anjennings/Tom80/V3/src/gal/U2101/README.md

# U2101
CPU GAL logic
See logic.pld for pin descriptions
