anjennings/Tom80/Schematics/Tom80 V2/V2.pdf

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
Title

Size | Number | Revision
C
Date: | 5/31/2021 | Sheet of
File: | Tom80V2.SchDoc | Drawn By:

A11 1
A12 2
A13 3
A14 4
A15 5
CLK 6
D4 7
D3 8
D5 9
D6 10
+5V 11
D2 12
D7 13
D0 14
D1 15
INT 16
NMI 17
HALT 18
MREQ 19
IORQ 20 | RD | 21 WR | 22 BUSAK | 23 WAIT | 24 BUSRQ | 25 RESET | 26 M1 | 27 RFSH | 28 GND | 29 A0 | 30 A1 | 31 A2 | 32 A3 | 33 A4 | 34 A5 | 35 A6 | 36 A7 | 37 A8 | 38 A9 | 39 A10 | 40

Z80

Zilog Z84C0008PEG

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
A11 | A10
A12
A13
A14
A15

Reset

WRITE
READ

MREQ
+5 | IORQ

CLK

GND

NC 1

Ground 7

RF-Out | 8
Vcc | 14

ZCLK

Abracon AACO-20.000MHZ-EK

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
Reset

+5

GND

C-RES

### 22 pf

M1

HALT

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
HALT

O2

OUT1

OUT2

POW
+5

1

2

3

P1

GND

## Master Reset Logic

## Z80 Clock

## Wall Wart

## Status LED Array

## Z80 CPU

D0 1
D1 2
D2 3
D3 4
D4 5
D5 6
D6 7
D7 8

ADS 25

A0 28
A1 27
A2 26

CS2 14

CTS 36

CS0 12
CS1 13
DCD | 38 DSR | 37

MR 35

RD 21

RI | 39
RCLK | 9

RD 22

SIN | 10
WR 18 | WR 19

XIN 16

BAUDOUT | 15
DTR | 33

DDIS 23

INTR | 30
OUT1 | 34
OUT2 | 31
RTS | 32

RXRDY 29

SOUT 11

TXRDY 24

XOUT 17

VDD 40 | VSS | 20

UART

PC16550DN

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
READ

WRITE

VDD 1

GP0 2
GP1 3
GP2 7
GP3 8

RST 4

URx 5
UTx 6

SDA 9
SCL 10
VUSB | | 11
D- | 12 D+ | 13
VSS | 14

USB-UART

Microchip MCP2221-I/P

+5

GND

Reset

D-D+

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
nReset

D+ 3

D- 2

GND 4

VBUS 1

5
6

PORT01

+5

XOUT 1 2

UCLK
Crystal

CX1

22pF

CX2

22pF

GND

XIN

XOUT

C-VU

22pF

OUT1
OUT2

DTR Acts as a latch to control the rom bank

ROM_LATCH

## 16550 Clock

RX

TX

GND

## UART-USB Bridge

## 16C550 UART

1
2
3
4
5
6
Vss 7 | 8

9

10

11

12

### 13 Vdd 14 NAND

Texas Instruments CD4011BM96 GND

1A 1
1B 2
1Y 3
2A 4
2B 5
2Y 6
GND 7
Vcc | 14
4A | 13
4B | 12
4Y | 11
3A | 10
3B | 9
3Y | 8

OR

SN74LS32N
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
G = nA 2

H = nB | 4
I =nC | 6
J = nD | 8
K = nE | 10
L = nF | 12
VDD | 14
VSS | 7

NOT

SYM-6032a9384922bff5-1

+5

GND

EN_RAM

E3 6

E2 5

E1 4

C

3

B

2

A

1 | Y0 | 15
| Y1 | 14
| Y2 | 13
| Y3 | 12
| Y4 | 11
| Y5 | 10
| Y6 | 9
| Y7 | 7
VCC | 16 GND 8

3-to-8 Decoder

MUX

A3

+5

GND

IORQ

/(nA15 * ROM_LATCH) = EN_ROM (Low At Reset)

EN_ROM

## NOT Gate

## Multiplexor

## NAND Gate

## OR Gate

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
EEPROM

Atmel AT28C256-15PU

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
MEMREAD

+5

+5

A0 | 12
A1 | 11
A2 | 10
A3 | 9
A4 | 8
A5 | 7
A6 | 6
A7 | 5
A8 | 27
A9 | 26
A10 | 23
A11 | 25
A12 | 4
A13 | 28
A14 | 3
A15 | 31
A16 | 2
A17 | 30
A18 | 1

DQ0 13
DQ1 14
DQ2 15
DQ3 17
DQ4 18
DQ5 19
DQ6 20
DQ7 21

OE 24
CE 22
WE 29

VCC 32 GND 16

SRAM

AS6C4008-55PCN

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
MEMREAD

MEMWRITE

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
SRAM enabled when ROM Disabled

Only Enabled when A15 Low AND Latch Set

EN_ROM

EN_RAM

## SRAM

## EEPROM

## Z80 PIO

GND

GND

C02

### 22 pf

C03
22pF

C04
22pF

C05
22pF

C06
22pF

C07
22pF

C08
22pF

C00
22pF

C01
22pF

+5

C09

### 22 pf

MEMREAD

READ

MREQ

RESET

nRESET

ROM_LATCH
nA15

EN_ROM

MREQ
WRITE
MEMWRITE

A15

nA15

D0 19
D1 20
D2 1

D7 2

D6 3

CE 4

C/D SEL 5

B/A SEL 6

PA7 | 7
PA6 | 8
PA5 | 9
PA4 | 10

GND 11

PA3 | 12 PA2 | 13 PA1 | 14 PA0 | 15
ASTB | 16
BSTB | 17
ARDY | 18
BRDY | 21

IEO 22

INT 23
IEI 24

CLK 25

+5V 26

PB0 | 27
PB1 | 28
PB2 | 29
PB3 | 30
PB4 | 31
PB5 | 32
PB6 | 33
PB7 | 34
RD 35 | IORQ 36 | M1 37
D5 38 | D4 39 | D3 40
Z80 PIO

PIO

Zilog Z84C2008PEG

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
PIO_EN
M1
IORQ
READ

+5

GND CLK

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
ARDY

BRDY

ASTB

BSTB

A0
A1

+5

PIO_SEL

PIO_INT

P0 | 1
P1 | 2
P2 | 3
P3 | 4
P4 | 5
P5 | 6
P6 | 7
P7 | 8

GND 9

BOEn 10
RESn 11

3.3V 12

P8 | 13 P9 | 14 P10 | 15 P11 | 16 P12 | 17 P13 | 18 P14 | 19 P15 | 20
P16 | 21 P17 | 22 P18 | 23 P19 | 24 P20 | 25 P21 | 26 P22 | 27 P23 | 28

GND 29

XI 30

XO 31

3.3V 32

P24 | 33 P25 | 34 P26 | 35 P27 | 36 P28 | 37 P29 | 38 P30 | 39 P31 | 40

PROP

Parallax P8X32A-D40

GND

+3.3

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
Case
Case

DB15-VGA

1-1734344-2
GND

VGA_BLU

VGA_GRN

VGA_RED

GND
VGA_HS
VGA_VS

1 2
PCLK
Crystal

+3.3

GND

A0 1

SDA 5

A2 3

A1 2 | WP | 7
VSS | 4
SCL | 6

VCC 8

S-ROM

24LC512-I/P

+3.3

SCL
SDA

GND

SCL

SDA

DAT2 1
CD/DAT3 2

CMD 3

VDD 4

CLK 5

VSS 6

DAT0 7
DAT1 8
S3 | 13
S4 | 14
| | S1 | 9
CD 11 | SW 10 | S2 | 12
| | S5 | 15

J03

MOLEX 503182-1852

GND

SD_D0

SD_CS

SD_DI
SD_CLK

SD_CD

+3.3

GND

PS2_DAT

PS2/CLK

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
VGA_BLU

VGA_GRN

VGA_RED

VGA_HS
VGA_VS

RB1

RG1

RR1

INT

(CTC_INT * PIO_INT) = INT (HIGH At Reset) nA15 and ROM_LATCH are HIGH at RESET

EN_ROM is LOW (active) at reset

ROM Disabled when addr > 0x7FFF or ROM_LATCH Low

Port A and all status lines are used for interfacing with Propeller

Used to interface with PS/2 Keyboard, VGA, and SD Card

SD_D0

SD_CS

SD_DI

SD_CLK

GND

PROP_RST

PROP_TX

PROP_RX

PS2_DAT
PS2/CLK

1
2
3
4

J02

61300411021

PROP_RST

PROP_RX

PROP_TX

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
# 6 GND GND

PS2

VCC | +5

GND

C101
.33uF

C100
100nF

C102
100nF

C103
10uF
Keystone 4816 | Keystone 4816 | Keystone 4816 | Keystone 4816

Footprint is 4816, use 2102-632-AL

CP-2260-ND

VGA_BLU | RB0
VGA_GRN | RG0
VGA_RED | RR0
IN 1 | 2
OUT | 3
GND

V02

LF33ABV

+3.3

SDA
SD_D0
SD_CS
SD_DI
SD_CLK

3 14

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
4116R-1-332

PA7

PA6

PA5

PA4

PA3

PA2

PA1

PA0 | P0 P1 P2 P3

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
SIP01

ARDY - Output, Active High - When High, data is available in the output register
ASTDB - Input, Active Low - When low, data from output register is gated onto the bus

BRDY - Output Active High - When high, Port A input is empty and ready to accept new data BSTDB - Input Active Low - When low, strobes data into Port A input register

+5

DCIN 1 | 2
VBAT | 3
GND

V01

7805

VCC

3 14

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
4116R-1-332

BSTB
BRDY
ASTB
ARDY
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
Reset | PROP_RST

CTC_SEL

PB1

PB0

PB2

D4 1
D5 2
D6 3
D7 4 | GND

5

RD 6

ZC/TO0 | 7
ZC/TO1 | 8
ZC/TO2 | 9

IORQ 10

IEO 11
INT 12

IEI 13

M1 14 | CLK 15

CE 16
RESET 17 CS0 18
CS1 19
CLK/TRG3 | 20
CLK/TRG2 | 21
CLK/TRG1 | 22
CLK/TRG0 | 23 +⁵V 24

D0 25
D1 26
D2 27
D3 28

CTC

Zilog Z84C3008PEG

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
CTC_EN

M1
IORQ
READ

CTC_INT

CTC_INT
PIO_INT
nINT

Reset

+5 GND

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
Power

NKK Switches CS12ANW03

VCC

C10

### 22 pf

1

2

VUSB

Molex 43045-0202

+5

JMPR

Sullins QPC02SXGN-RC

PS2_DAT

PS2/CLK

PIO_INT_O

PIO_INT_O
CTC_INT_O

M1
IORQ
INT_ACK

INT_ACK

INT_ACK is active low

IORQ

A4

INT

nINT

CTC_SEL
INT_ACK
nCTC_EN

nCTC_EN

CTC_EN

PIO_SEL

INT_ACK

nPIO_EN

nPIO_EN

PIO_EN

A4

PIO is bXXX00XAA (0-3)
CTC is bXXX01XAA (8-11)

UART is XXX1XAAA (16-23)

Pins 0-2 of Port B are used for Ram Bank Control

IO Enables are active (low) when Interrupt is acknowledged or when port is selected

M1

10K

C20

### 22 pf

+3.3

GND

This schematic has several KNOWN ISSUES.

# It is provided for reference ONLY

## PS2 Port

## SD Card
