anjennings/Tom80/Schematics/EEPROM Programmer/EEPROM Programmer.pdf

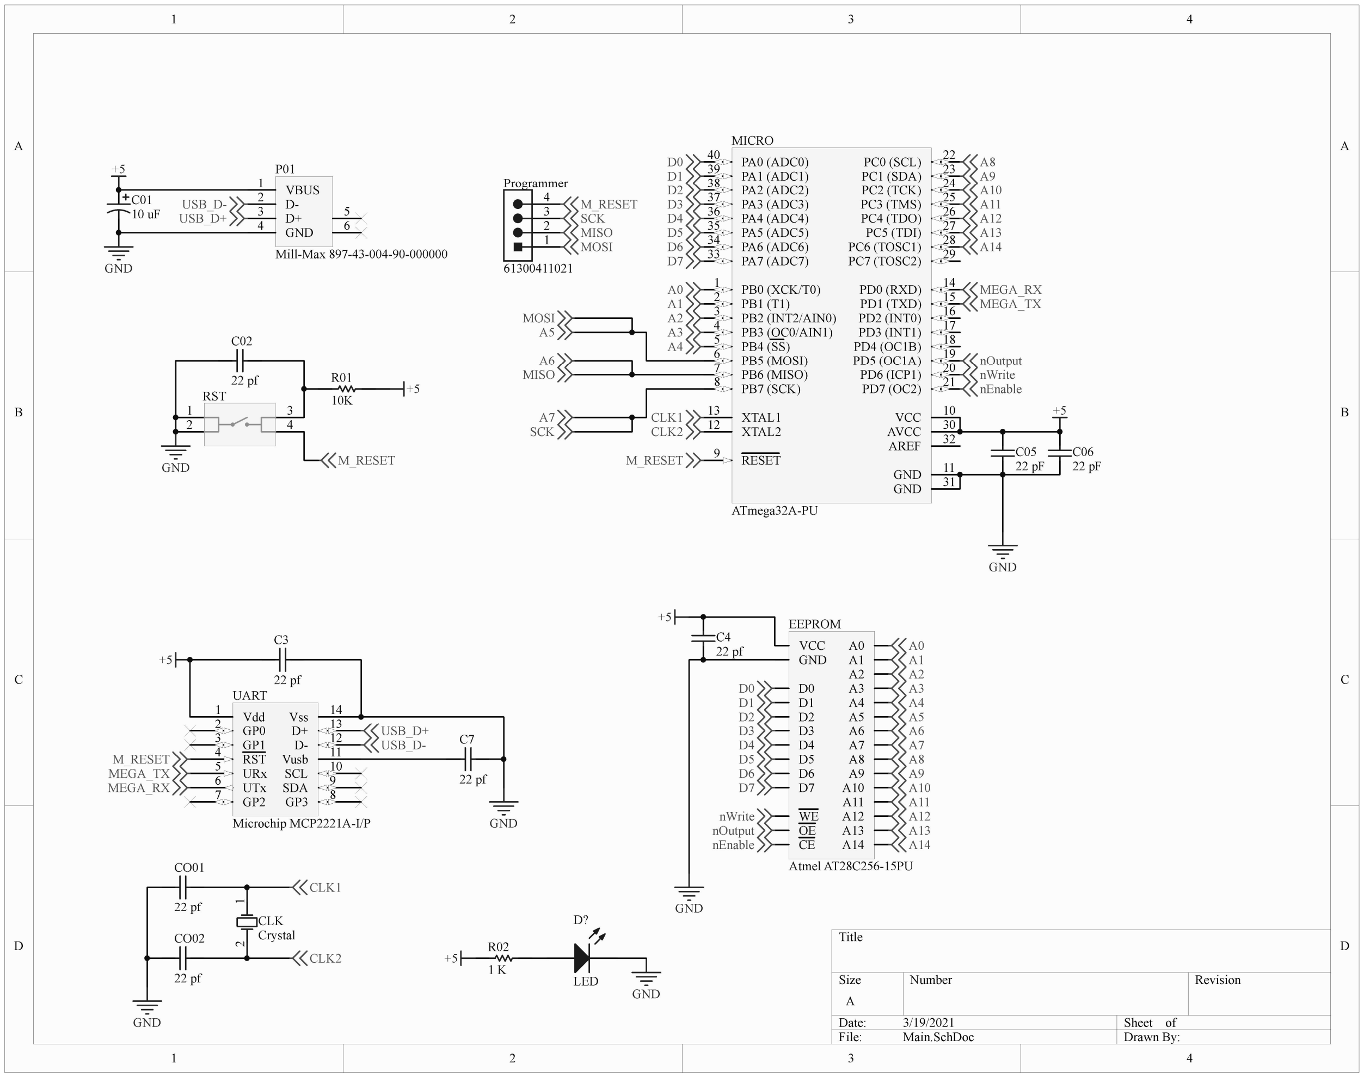
[picture p2: page 1]

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
Title

Size | Number | Revision
A
Date: | 3/19/2021 | Sheet of
File: | Main.SchDoc | Drawn By:

D+ 3

D- 2

GND 4

VBUS 1

5
6

P01

Mill-Max 897-43-004-90-000000

USB_D-USB_D+

Vdd 1
GP0 2
GP1 3
RST 4
URx 5
UTx 6
GP2 7 | GP3 | 8
| SDA | 9
SCL | 10 Vusb | 11 D- | 12 D+ | 13 Vss | 14

UART

Microchip MCP2221A-I/P

USB_D+
USB_D-M_RESET

GND

PB0 (XCK/T0) 1
PB1 (T1) 2
PB2 (INT2/AIN0) 3
PB3 (OC0/AIN1) 4
PB4 (SS) 5
PB5 (MOSI) 6
PB6 (MISO) 7
PB7 (SCK) 8

RESET 9

XTAL2 12 | XTAL1 13
PD0 (RXD) | 14
PD1 (TXD) | 15
PD2 (INT0) | 16
PD3 (INT1) | 17
PD4 (OC1B) | 18
PD5 (OC1A) | 19
PD6 (ICP1) | 20
PD7 (OC2) | 21
PC0 (SCL) | 22
PC1 (SDA) | 23
PC2 (TCK) | 24
PC3 (TMS) | 25
PC4 (TDO) | 26
PC5 (TDI) | 27
PC6 (TOSC1) | 28
PC7 (TOSC2) | 29 PA7 (ADC7) 33 | PA6 (ADC6) 34 | PA5 (ADC5) 35 | PA4 (ADC4) 36 | PA3 (ADC3) 37 | PA2 (ADC2) 38 | PA1 (ADC1) 39 | PA0 (ADC0) 40
VCC | 10
GND | 11
AVCC | 30
GND | 31
AREF | 32

MICRO

ATmega32A-PU

MEGA_RX
MEGA_TX

GND

M_RESET

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
EEPROM

Atmel AT28C256-15PU

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
nWrite

nEnable

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
CLK1
CLK2

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
MEGA_RX

MEGA_TX

1

2

3

4

Programmer

61300411021

MOSI

MISO

SCK

M_RESET

MOSI

SCK

MISO
nEnable

nWrite

+5

GND

nOutput

nOutput

+5

1 +5
2

3
4

RST

M_RESET

+5

GND

C01

### 10 uF

D?

LED

R02

### 1 K

+5

GND

R01
10K

C3

### 22 pf

C02

### 22 pf

C4

### 22 pf

C06

### 22 pF

C05

### 22 pF

C7

### 22 pf 1 2

CLK
Crystal

CO01

### 22 pf

CO02

### 22 pf

GND

CLK1

CLK2
