anjennings/Tom80/Old/README.md

# Old Files

Everything in this directory is old and no longer in development
Most of these files are related to prototypes or the original EEPROM programmer
