anjennings/Tom80/V2/src/README.md

# Assembly Source Code

Dump of all the assembly programs I've written for V2.  Some are just tests of peripherals while others are ongoing projects.  

* ASH - Memory monitor, mostly finished
* CPM - Port of CPM 2.2, unfinished and untested
* CPM_Bootloader - Bootloader routine to launch CPM
* Tinybasic - Version of Tinybasic ported by [Doug Gabbard](retroDepot.net), modified for Tom80
* FUZIX - Backup files for a port of FUZIX, requires a fork of EtchedPixels/FUZIX repo to compile, V2B only
* Shared - header files for ASH/CPM/Bootloader

Makefiles require you to specify the location of an assembler executable

Everything else is some test used to see if some aspect of the board is functioning.  I make no claims about the quality of these tests,  none of them are designed to be all encompassing.

## Assemblers

If a makefile is included its probably designed for
[Pasmo](http://pasmo.speccy.org/)

Otherwise you can use [ASM80](https://www.asm80.com/)
