anjennings/Tom80/V1/README.md

# Tom80 V1.X

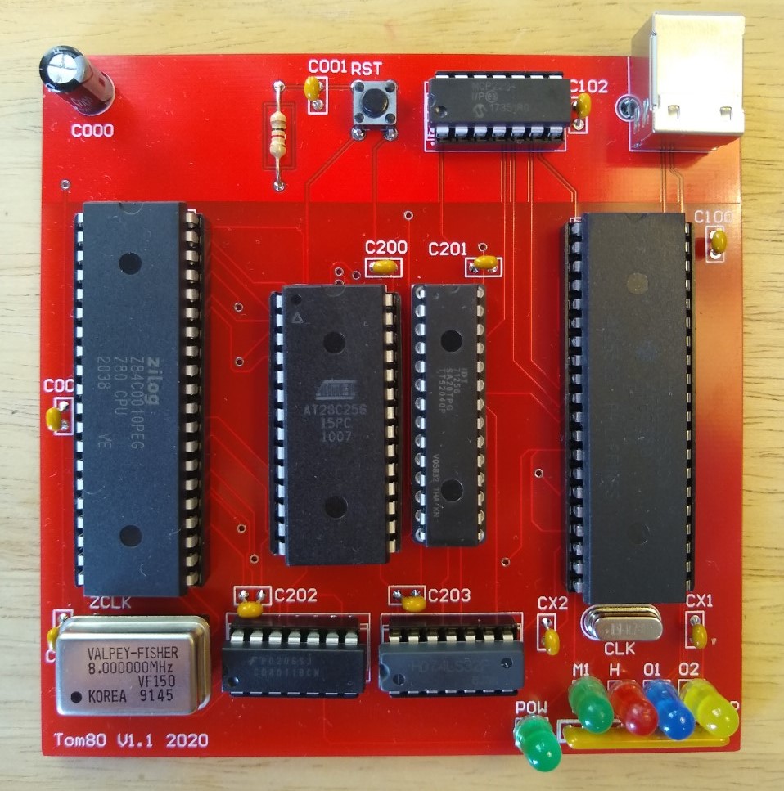
[picture p3: Photos/Tom80.jpg]


Two versions of V1 exist:

	* V1.0 - Never got it working, only version assembled was scrapped for parts
	* V1.1 - The one in all the pictures
	
See the video about it : https://youtu.be/3KAjZbjPqnA
	
This version has no persistant memory or way of keeping time so an OS wouldn't really be worth the effort

It can run BASIC and looks nice on the shelf
