anjennings/Tom80/Photos/EEPROM Programmer.jpg

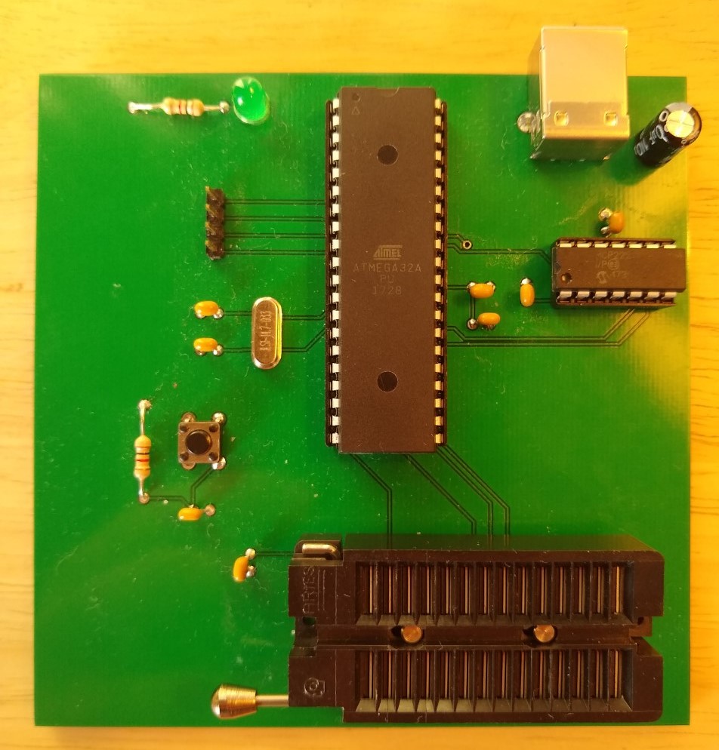
Photos/EEPROM Programmer.jpg
