anjennings/Tom80/Photos/Prototype 1.jpg

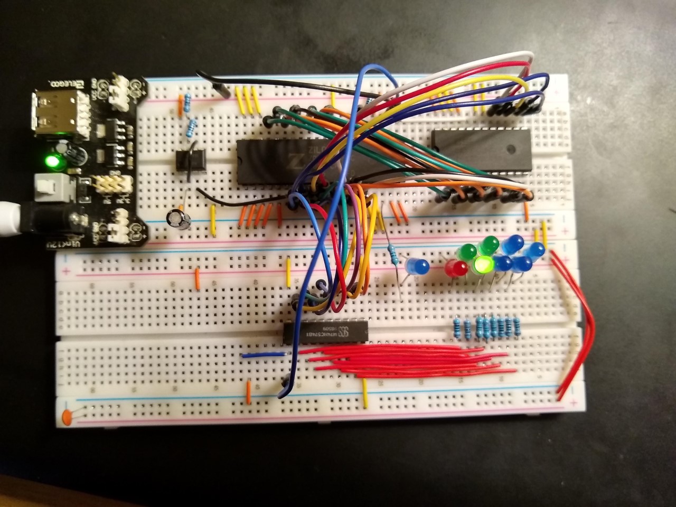
Photos/Prototype 1.jpg
