anjennings/Tom80/Photos/Prototype 2.jpg

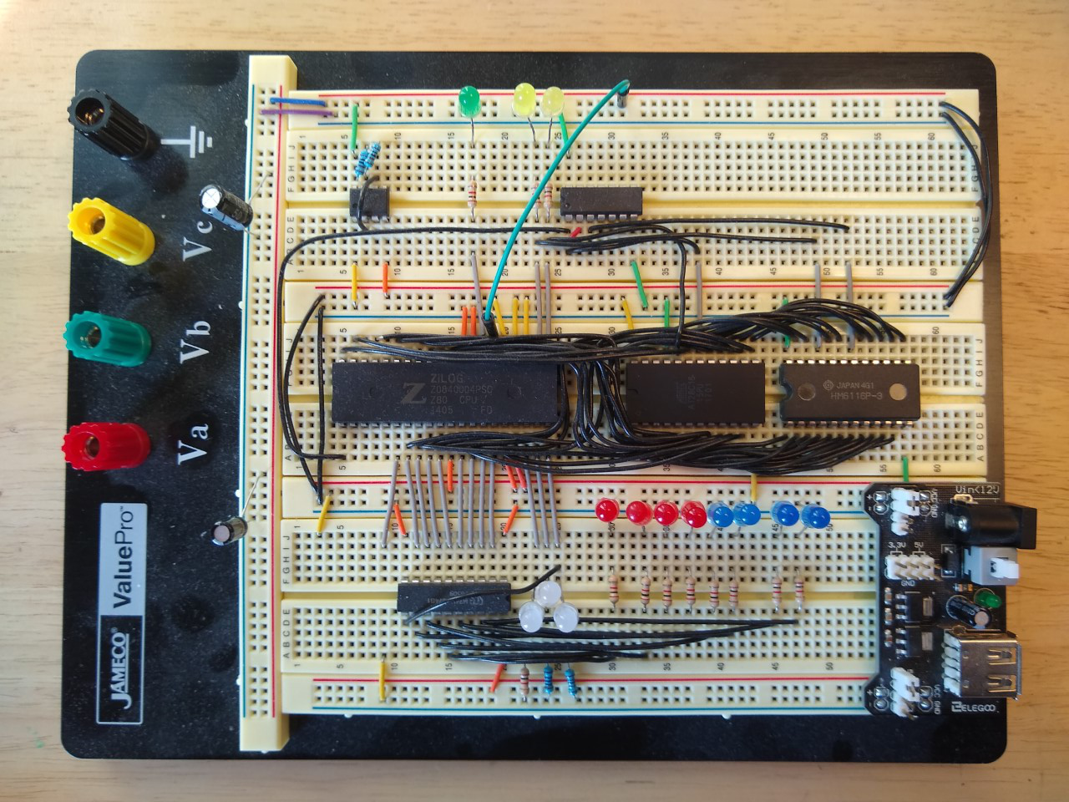
Photos/Prototype 2.jpg
