anjennings/Tom80/Photos/V2 Partial.jpg

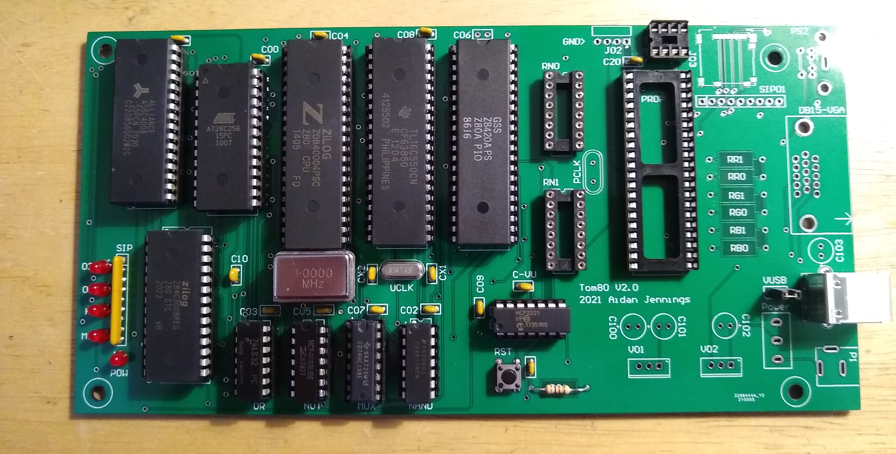
Photos/V2 Partial.jpg
