anjennings/Tom80/(threads)

Thread 1 (2021-03-19):

unconnected tag

mrobl320, 2021-03-19:
On the schematic for the eeprom programmer there is a VUSB tag that is not connected to anything so does it go to some pin of something or not?

anjennings, 2021-03-19:
VUSB should be connected to a capacitor if operating at 5V, per the datasheet, good catch.
This was added in a later version of the schematic that I have apparently failed to upload.
Sorry about any confusion this may have caused.

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

anjennings, 2021-03-19:
New version of schematic is now in master

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

Closed 2021-03-19.
