anjennings/Tom80/V3/kicad/z80vga.pdf

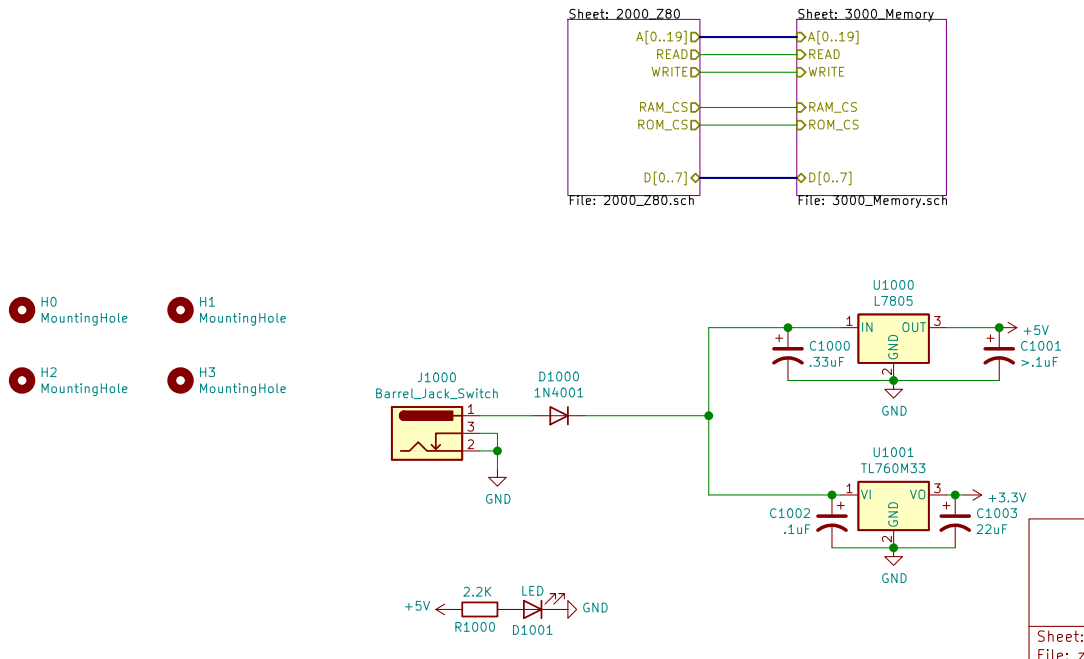
[picture p8: page 1]

Sheet: 2000_Z80 File: 2000_Z80.sch D[0..7] WRITE READ

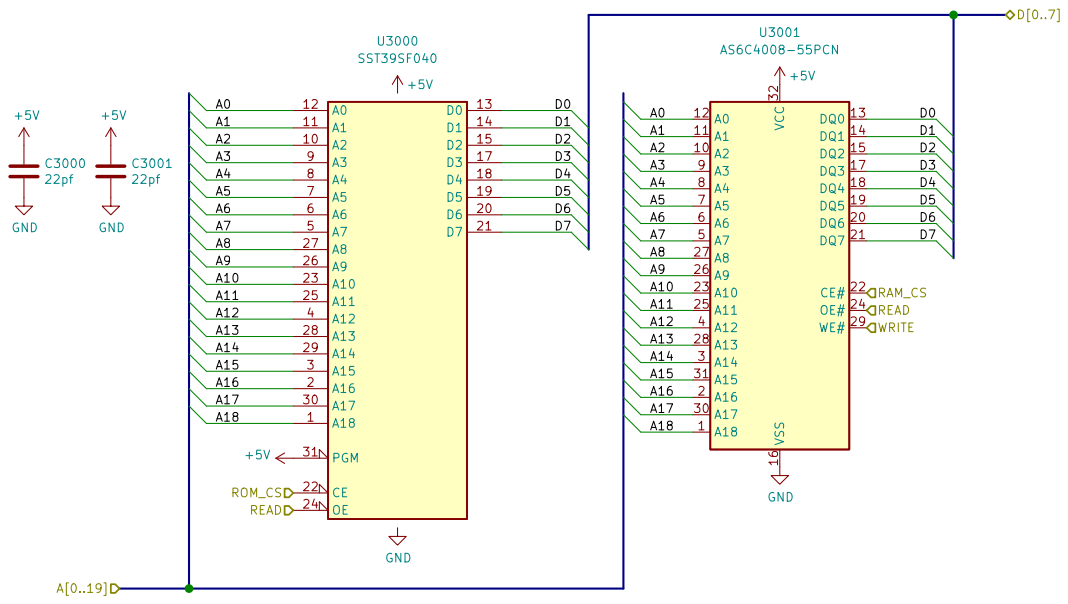
[picture p9: page 2]

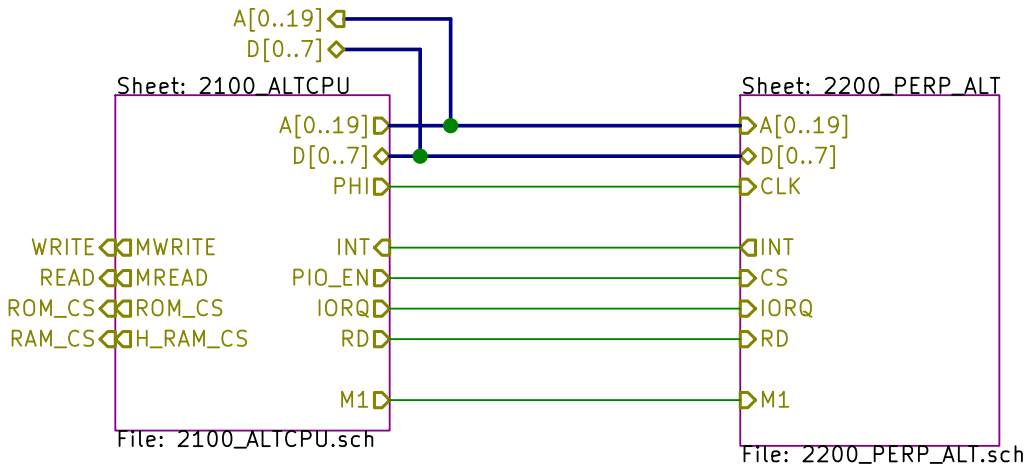
[picture p10: page 3]

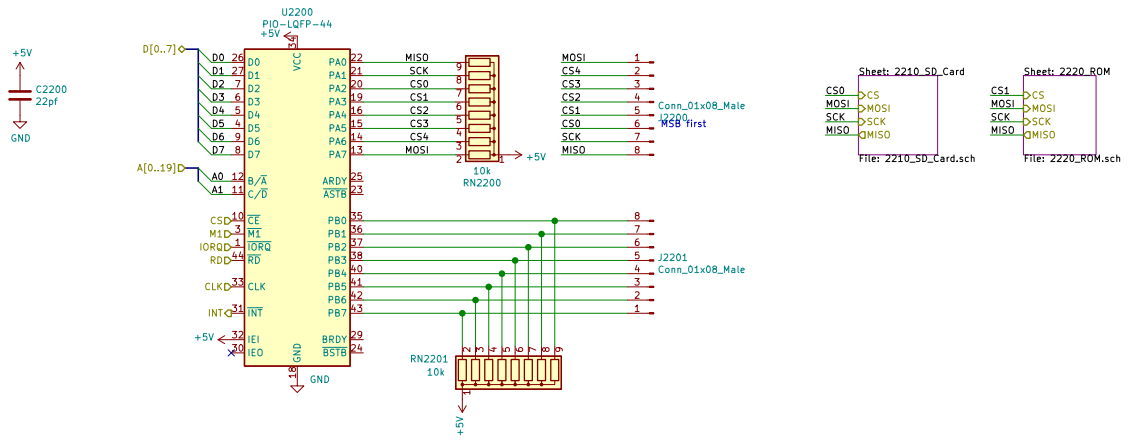
[picture p11: page 4]

Sheet: 2210_SD_Card File: 2210_SD_Card.sch CSMOSI SCK MISO

File: 2220_ROM.sch CSMOSI MISO

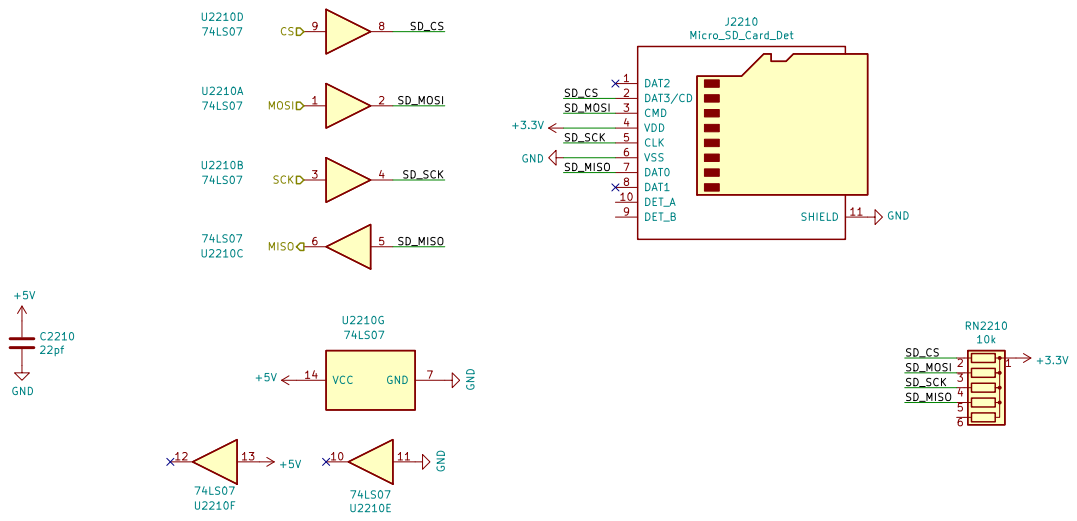
[picture p12: page 5]

J2210 Micro_SD_Card_Det +5V
+3.3V CS MOSI SCK MISO

SD_MOSI SD_CS
SD_MISO This page has been checked!

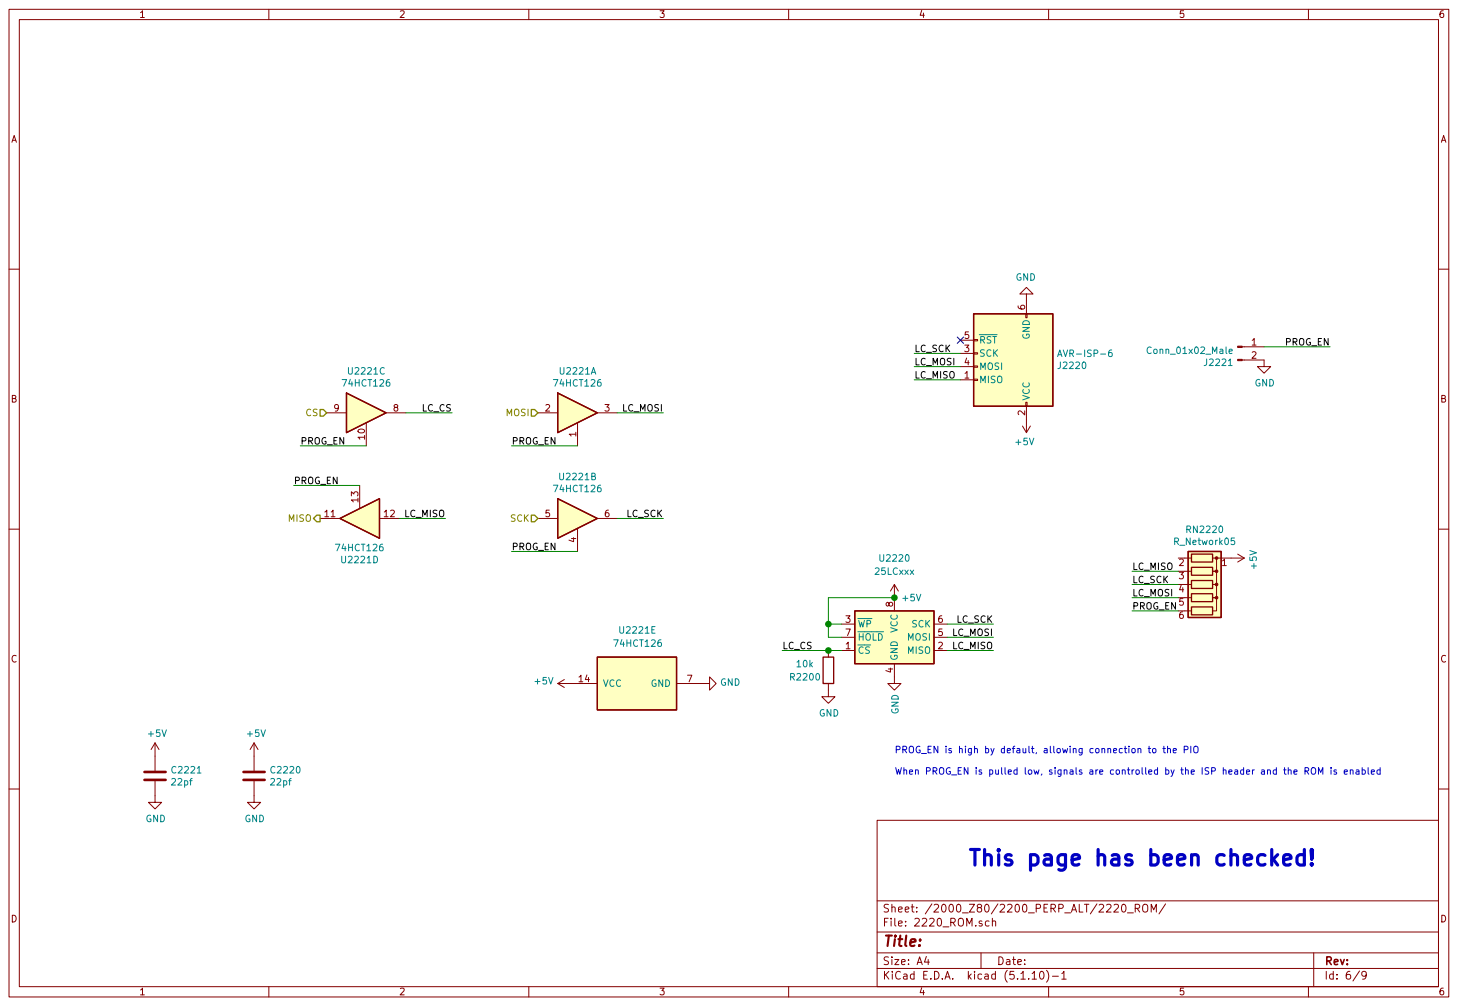
[picture p13: page 6]

2 SCK 3 MOSI 4 RST 5 GND

4 MOSI 5 SCK 6 HOLD 7 VCC

PROG_EN is high by default, allowing connection to the PIO

When PROG_EN is pulled low, signals are controlled by the ISP header and the ROM is enabled

This page has been checked!

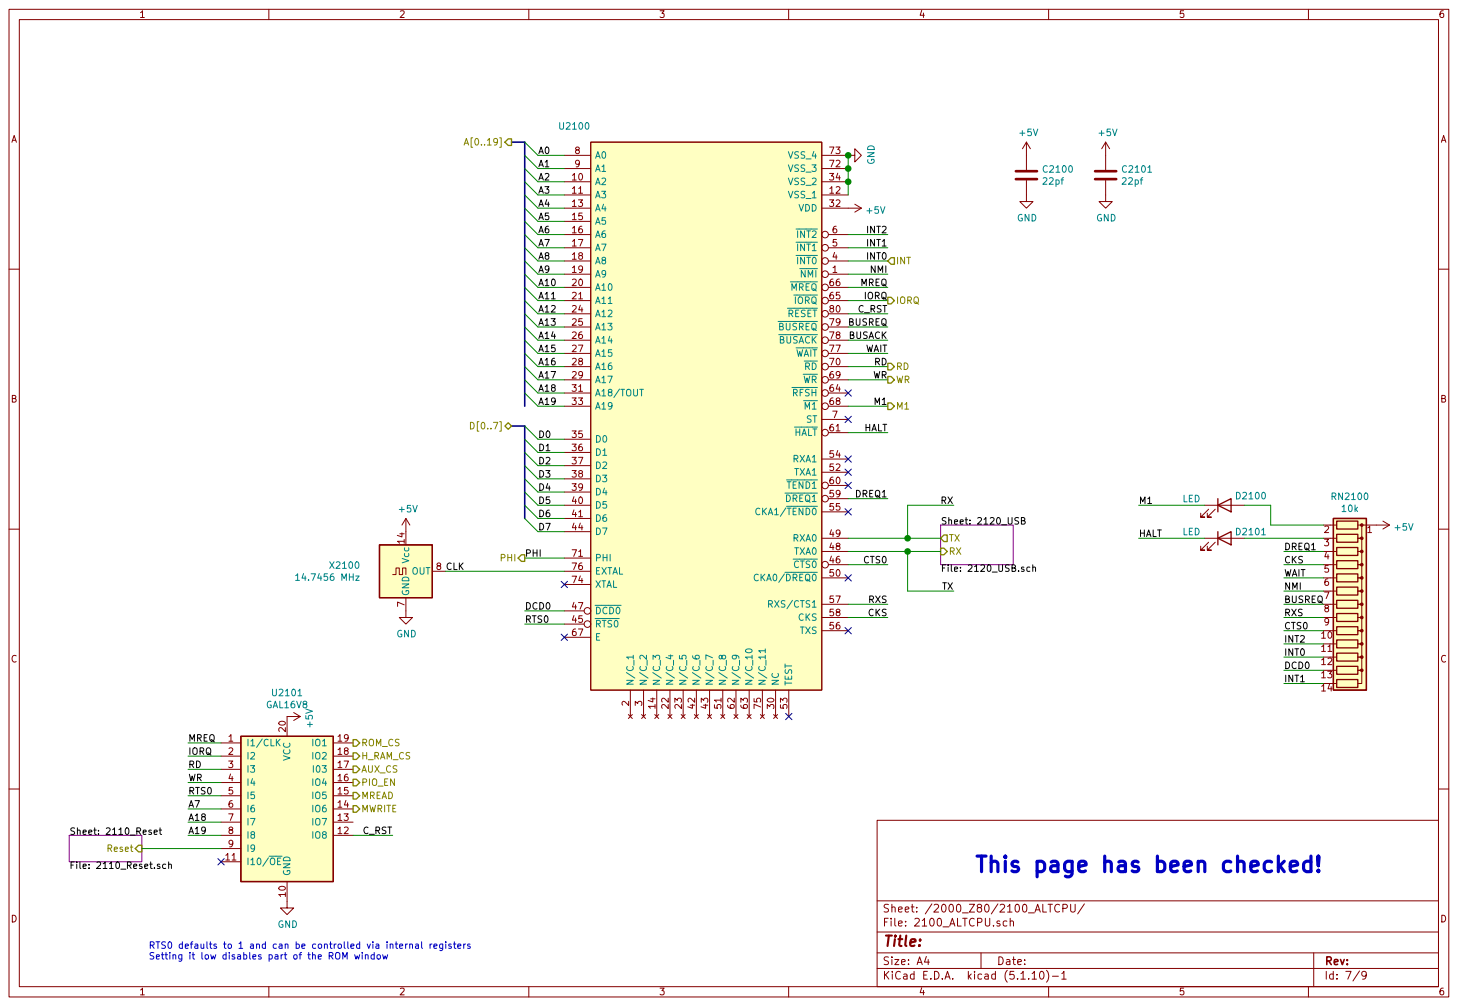
[picture p14: page 7]

File: 2120_USB.sch TXRX GND 10 VCC 20

RTS0 defaults to 1 and can be controlled via internal registers
Setting it low disables part of the ROM window

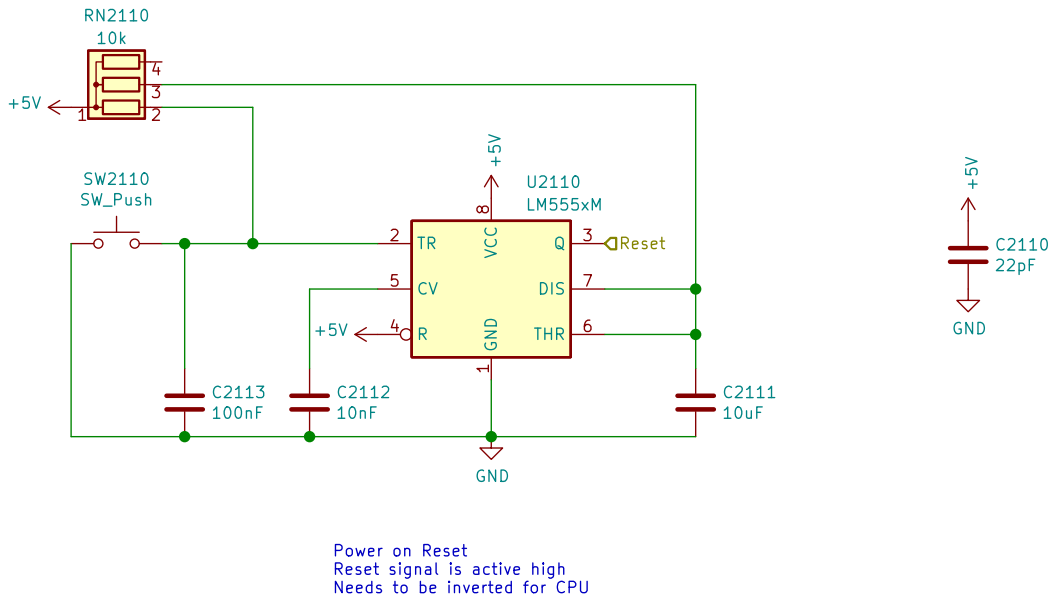
[picture p15: page 8]

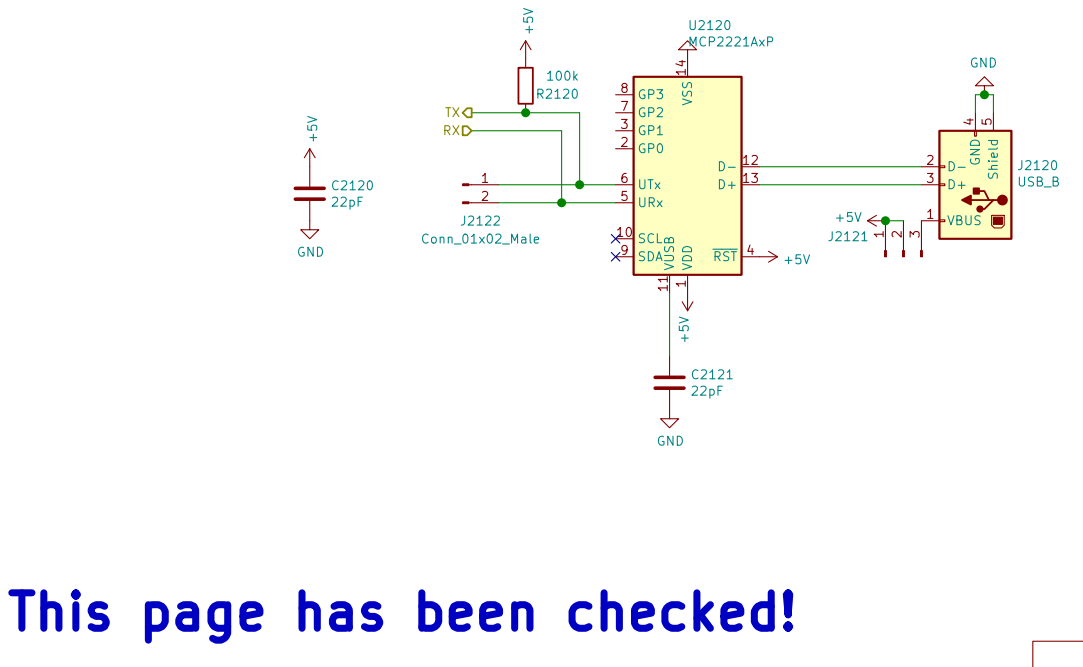
[picture p16: page 9]

1 SCL 10 VUSB 11 D- 12 D+ 13 VSS 14 GP0 2 GP1 3 RST 4 URx 5 UTx 6 GP2 7 GP3 8 SDA 9 U2120 MCP2221AxP

TXRX This page has been checked!
