anjennings/Tom80/Schematics/Tom80 V1/Memory.pdf

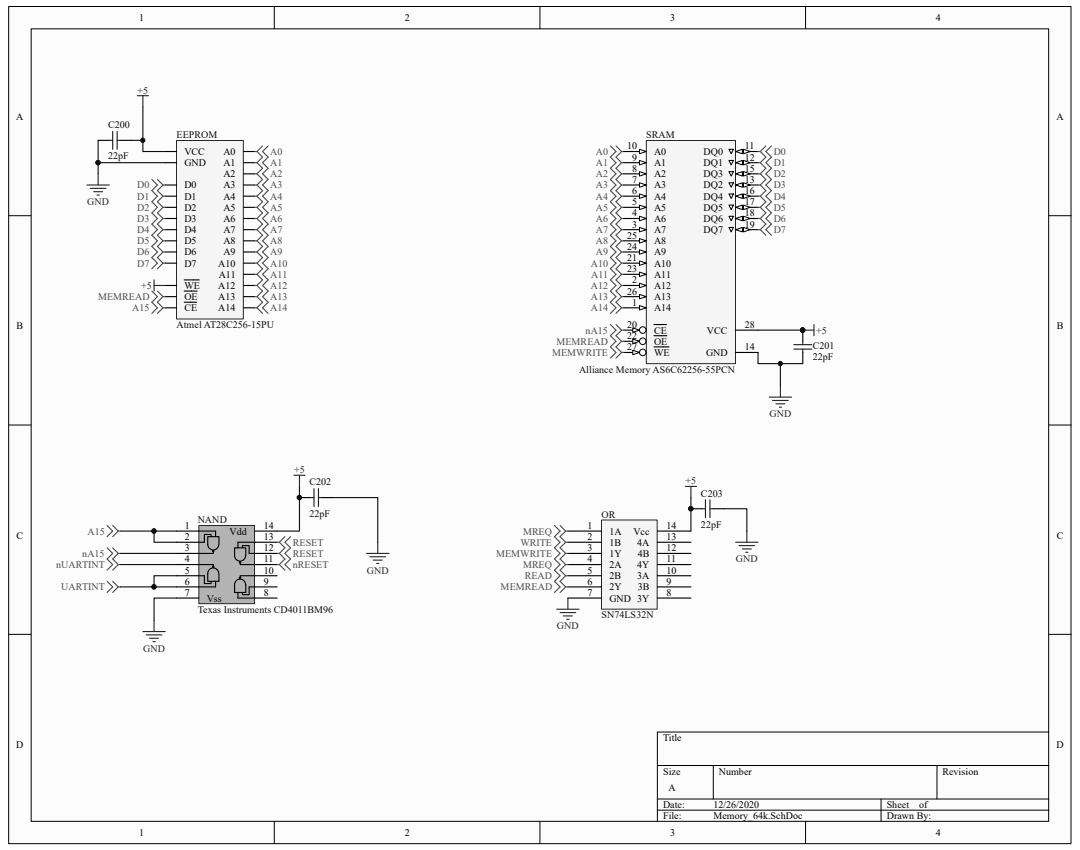
[picture p17: page 1]
