anjennings/Tom80/(list of files, drawings)

Other design files:
V3/kicad/z80vga.dsn
