anjennings/Tom80/V3/kicad/z80vga.kicad_pcb

## KiCad design V3/kicad/z80vga.kicad_pcb (2023-11-24)

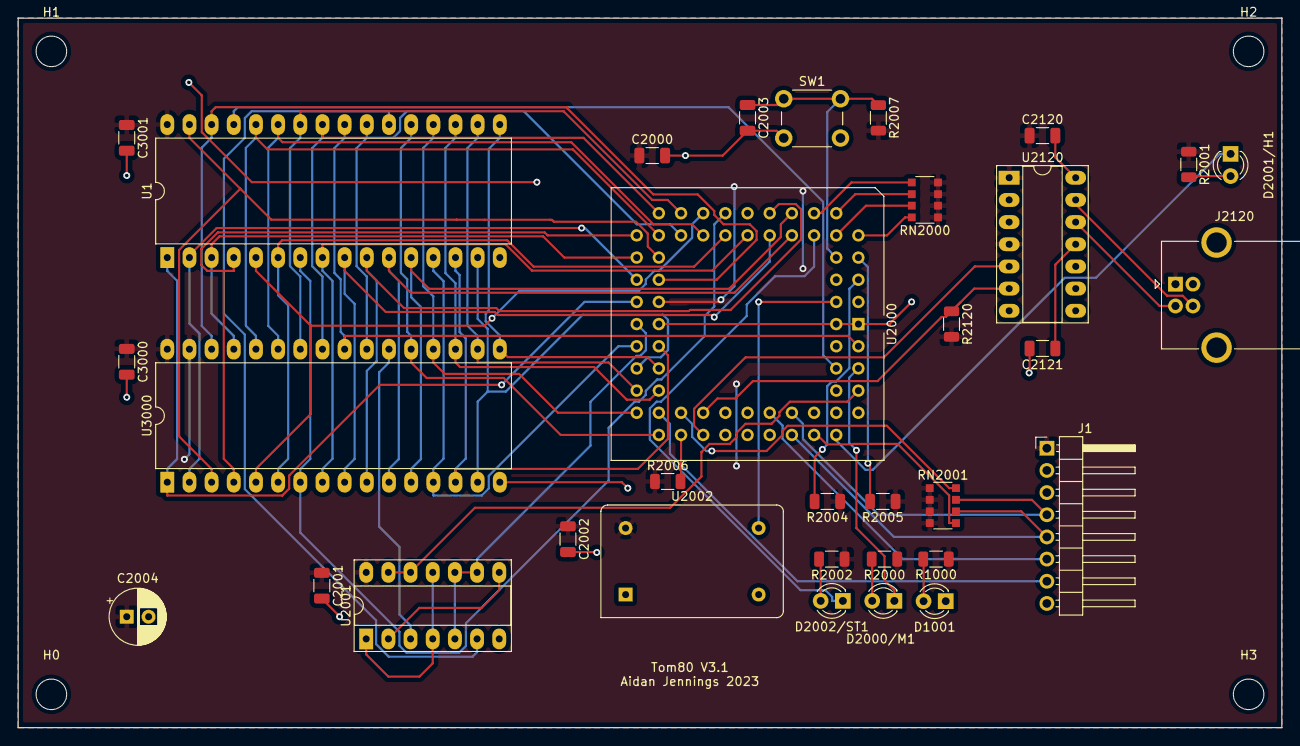
[picture p18: board z80vga.kicad_pcb from above]

Board: 2 copper layers, 144.8 x 81.3 mm, 37 parts (0 on the bottom side), 64 nets.

Parts:
C2000, C2001, C2002, C2003, C3000, C3001: 22pf; C_1206_3216Metric
C2004: 1uF; CP_Radial_D6.3mm_P2.50mm
C2120, C2121: 22pF; C_1206_3216Metric
D1001, D2000/M1, D2001/H1, D2002/ST1: LED; LED_D3.0mm
H0, H1, H2, H3: MountingHole; MountingHole_3.5mm
J1: Conn_01x08_Male; PinHeader_1x08_P2.54mm_Horizontal
J2120: USB_B; USB_B_OST_USB-B1HSxx_Horizontal
R1000: 2.2K; R_1206_3216Metric
R2000, R2001, R2002, R2004, R2005, R2006, R2007: R; R_1206_3216Metric
R2120: 100k; R_1206_3216Metric
RN2000, RN2001: 4 x 10K; R_Array_Convex_4x1206
SW1: SW_Push; SW_PUSH_6mm
U1: AS6C4008-55PCN; DIP-32_W15.24mm_LongPads
U2000: Z8-L180-S180-180-PLCC-68; PLCC-68_THT-Socket
U2001: 74HCT00; DIP-14_W7.62mm_Socket_LongPads
U2002: 14.7456 MHz; Oscillator_DIP-14
U2120: MCP2221AxP; DIP-14_W7.62mm_Socket_LongPads
U3000: SST39SF040; DIP-32_W15.24mm_LongPads

Connections:
+5V: C2000.1, C2001.1, C2002.1, C2004.1, C2120.1, C3000.1, C3001.1, J1.1, J2120.1, R1000.2, R2000.1, R2001.1, R2002.1, R2004.1, R2005.1, R2006.1, R2007.2, R2120.2, RN2000.1, RN2000.2, RN2000.3, RN2000.4, RN2001.1, RN2001.2, RN2001.3, RN2001.4, U1.32, U2000.34, U2001.14, U2002.14, U2120.1, U2120.4, U3000.31, U3000.32
/2000_CPU/A0: U1.12, U2000.14, U3000.12
/2000_CPU/A1: U1.11, U2000.15, U3000.11
/2000_CPU/A2: U1.10, U2000.16, U3000.10
/2000_CPU/A3: U1.9, U2000.17, U3000.9
/2000_CPU/A4: U1.8, U2000.19, U3000.8
/2000_CPU/A5: U1.7, U2000.20, U3000.7
/2000_CPU/A6: U1.6, U2000.21, U3000.6
/2000_CPU/A7: U1.5, U2000.22, U3000.5
/2000_CPU/A8: U1.27, U2000.23, U3000.27
/2000_CPU/A9: U1.26, U2000.24, U3000.26
/2000_CPU/A10: U1.23, U2000.25, U3000.23
/2000_CPU/A11: U1.25, U2000.26, U3000.25
/2000_CPU/A12: U1.4, U2000.27, U3000.4
/2000_CPU/A13: U1.28, U2000.28, U3000.28
/2000_CPU/A14: U1.3, U2000.29, U3000.29
/2000_CPU/A15: U1.31, U2000.30, U3000.3
/2000_CPU/A16: U1.2, U2000.31, U3000.2
/2000_CPU/A17: U1.30, U2000.32, U3000.30
/2000_CPU/A18: U1.1, U2000.33, U3000.1
/2000_CPU/A19: U2000.35, U2001.5, U2001.9, U2001.10
/2000_CPU/BUSREQ: R2005.2, U2000.7
/2000_CPU/CKS: J1.4, RN2001.7, U2000.57
/2000_CPU/CLK: U2000.4, U2002.8
/2000_CPU/CTS0: R2006.2, U2000.46
/2000_CPU/C_RST: C2003.1, R2007.1, SW1.1, U2000.8
/2000_CPU/D0: U1.13, U2000.37, U3000.13
/2000_CPU/D1: U1.14, U2000.38, U3000.14
/2000_CPU/D2: U1.15, U2000.39, U3000.15
/2000_CPU/D3: U1.17, U2000.40, U3000.17
/2000_CPU/D4: U1.18, U2000.41, U3000.18
/2000_CPU/D5: U1.19, U2000.42, U3000.19
/2000_CPU/D6: U1.20, U2000.43, U3000.20
/2000_CPU/D7: U1.21, U2000.44, U3000.21
/2000_CPU/DCD0: RN2001.8, U2000.47
/2000_CPU/DREQ1: RN2001.5, U2000.58
/2000_CPU/HALT: D2001/H1.1, U2000.60
/2000_CPU/INT0: RN2000.6, U2000.10
/2000_CPU/INT1: RN2000.7, U2000.11
/2000_CPU/INT2: RN2000.5, U2000.12
/2000_CPU/M1: D2000/M1.1, U2000.65
/2000_CPU/MREQ: U2000.63, U2001.12, U2001.13
/2000_CPU/NMI: RN2000.8, U2000.9
/2000_CPU/RAM_CS: U1.22, U2001.6
/2000_CPU/RD: U1.24, U2000.67, U3000.24
/2000_CPU/ROM_CS: U2001.3, U3000.22
/2000_CPU/RTS0: J1.7, U2000.45
/2000_CPU/RX: R2120.1, U2000.49, U2120.6
/2000_CPU/RXS: J1.5, RN2001.6, U2000.56
/2000_CPU/ST: D2002/ST1.1, U2000.13
/2000_CPU/TX: U2000.48, U2120.5
/2000_CPU/TXS: J1.6, U2000.55
/2000_CPU/WAIT: R2004.2, U2000.5
/2000_CPU/WR: U1.29, U2000.66
GND: C2000.2, C2001.2, C2002.2, C2003.2, C2004.2, C2120.2, C2121.2, C3000.2, C3001.2, D1001.1, J1.3, J2120.4, J2120.5, SW1.2, U1.16, U2000.1, U2000.2, U2000.18, U2000.36, U2001.7, U2002.7, U2120.14, U3000.16
unnamed: C2121.1, U2120.11
unnamed: D1001.2, R1000.1
unnamed: D2000/M1.2, R2000.2
unnamed: D2001/H1.2, R2001.2
unnamed: D2002/ST1.2, R2002.2
unnamed: J2120.2, U2120.12
unnamed: J2120.3, U2120.13
unnamed: U2001.1, U2001.4, U2001.11
unnamed: U2001.2, U2001.8
