anjennings/Tom80/EEPROM Firmware/EEPROM Firmware/EEPROM Firmware/FIRMWARE.h

/*
 * FIRMWARE.h
 *
 * Created: 12/18/2020 10:52:10 AM
 *  Author: Aidan
 */ 

//One big include file for all items in the project

#ifndef FIRMWARE_H_
#define FIRMWARE_H_

#include <stdio.h>
#include <stdint-gcc.h>
#include <stdlib.h>

#include "USART.h"
#include "MAIN.h"
#include "Monitor.h"
#include "SRAM.h"

#include "avr\io.h"

//Must be included last
#include <util/delay.h>


#endif /* FIRMWARE_H_ */
