anjennings/Tom80/EEPROM Firmware/EEPROM Firmware/EEPROM Firmware/Monitor.h

/*
 * Monitor.h
 *
 * Created: 10/6/2020 7:08:29 PM
 *  Author: Aidan
 */ 


#ifndef MONITOR_H_
#define MONITOR_H_

void monitor();

void dumbMonitor();

void monitorLoop();

void evaluateExpression(char * i);

void dump();

#endif /* MONITOR_H_ */
