anjennings/Tom80/(commit log)

2020-04-15 got EEPROM programmer working
    [Z80 PCB.PrjPcb]
2020-08-20 updated readme and removed old files
    [Z80 PCB.PrjPcb]
2020-09-10 added schematics
2020-09-28 added schematic for custom EEPROM Programmer
2020-10-11 I think the UART should be correct now
2020-11-15 Sent away for the PCBs
2020-12-19 big updates since last time
    [64k_Final.DRL, 64k_Final.GBL, 64k_Final.GBO, 64k_Final.GBP, 64k_Final.GBS, 64k_Final.GKO, 64k_Final.GTL, 64k_Final.GTO]
2020-12-26 reorganized file structure
    [64k_Final.DRL, 64k_Final.GBL, 64k_Final.GBO, 64k_Final.GBP, 64k_Final.GBS, 64k_Final.GKO, 64k_Final.GTL, 64k_Final.GTO]
2021-01-02 added photos of completed boards and some of the prototypes
2021-01-03 changed some of the source code to be compatable with different assemblers
2021-01-10 printstr works!
2021-03-19 Final Version of Programmer Schematic
2021-05-17 added photo of partly assembled V2
2021-05-23 Created dumb terminal test for Prop
2021-05-23 ASH VGA has drivers to print text to screen
2021-05-26 Monitor now detects if propeller is active on boot
2021-06-03 switched from printf to print
    absolutely atrocious libraries, printf doesn't work sometimes
2021-06-06 Added prop support for Drive B:
2021-08-19 removed VGA core from propeller firmware
2021-10-12 Still troubleshooting pio drivers
2022-05-30 3.0 planning (#7)
    * Added kicad files
    * probably going to split into two boards
    * Copied GAL files
    * Delete TODO.md
    * updated GAL makefile
    * Updated GAL Logic
    * Updated GAL logic for different ROM chip
    * Updated PCB files
    * fixing up CPU page and routing
    * Fixed a few USB/UART issues
    * Still putting final touches on CPU page
    * altered logic to reflect schematic
    * Hopefully the last major changes to the CPU
    * last touches on peripherals and memory
    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
    [1000_Reset.sch, 2000_Z80.sch, 2100_ALTCPU.sch, 2110_Reset.sch, 2120_USB.sch, 2200_PERP_ALT.sch, 2210_SD_Card.sch, 2220_ROM.sch]
2022-05-30 3.0 planning no header (#8)
    * Cleaned up a few more pages
    * new footprints and fixed reset routes
    * last changes before autoroute
    * minor changes to make routing easier
    * still trying to make routes work
    * fixe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
2023-10-28 3 1 1 m memory (#15)
    * moved EEPROM files to /old
    * Reworking 3.0 board
    * changed footprint on RAM chip
    * cleared out old memory traces
    * started on rerouting
    * on to autoroute
    * little more cleanup
    * more cleanup
    * ill let the autoroute do the rest
    * reroute complete
    * made PQFP leads fatter
    * Updated GAL logic
    * Design Rule Check
    * Minor pcb touch up
    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
    [2000_CPU.sch, 2000_Z80.sch, 2110_Reset.sch, 2120_USB.sch, 2200_PERP_ALT.sch, 2220_ROM.sch, 2230_SD_Card.sch, 3000_Memory.sch]
2023-10-28 Replace chip with PLCC, strip out uncritical elements
    [2000_CPU.sch, 2110_Reset.sch, 2120_USB.sch, 3000_Memory.sch, z80vga.kicad_pcb, z80vga.sch]
2023-10-28 new board layout, not routing yet, still need to check schematics
    [2110_Reset.sch, 2120_USB.sch, z80vga.kicad_pcb]
2023-11-04 updated pcbs some more
    [3000_Memory.sch, z80vga.kicad_pcb]
2023-11-04 Replace reset with simpler circuit
    [2000_CPU.sch, 2120_USB.sch, 3000_Memory.sch, z80vga.sch]
2023-11-04 replace GAL with 74 series logic
    [2000_CPU.sch]
2023-11-04 rearranged pcb a bit
    [2000_CPU.sch, z80vga.kicad_pcb]
2023-11-18 finalize board layout, just need to route
    [z80vga.kicad_pcb]
2023-11-18 easy routes are done
    [2000_CPU.sch, 2120_USB.sch, z80vga.kicad_pcb]
2023-11-18 double checked CPU signals
    [2000_CPU.sch]
2023-11-18 regen netlist
    [z80vga.kicad_pcb]
2023-11-19 moved resistor array
    [2000_CPU.sch, z80vga.kicad_pcb]
2023-11-19 ran autoroute
    [z80vga.dsn, z80vga.kicad_pcb]
2023-11-19 final routes
    [z80vga.kicad_pcb]
2023-11-24 final, minor fixes
    [2000_CPU.sch, z80vga.kicad_pcb]
2023-11-24 missed one unconnected
    [z80vga.kicad_pcb]
2023-11-24 generated gerber and drill files
    [z80vga-B_Cu.gbl, z80vga-B_Mask.gbs, z80vga-B_Paste.gbp, z80vga-B_SilkS.gbo, z80vga-Edge_Cuts.gm1, z80vga-F_Cu.gtl, z80vga-F_Mask.gts, z80vga-F_Paste.gtp]
